DanNixon/microsd-hexpansion/README.md

# uSD Card Hexpansion

Micro SD card hexpansion for the [Tildagon](https://tildagon.badge.emfcamp.org/) badge.

- [Purchase](https://themachineshop.uk/products/dual-sd-card-hexpansion)
- [Documentation](./docs)

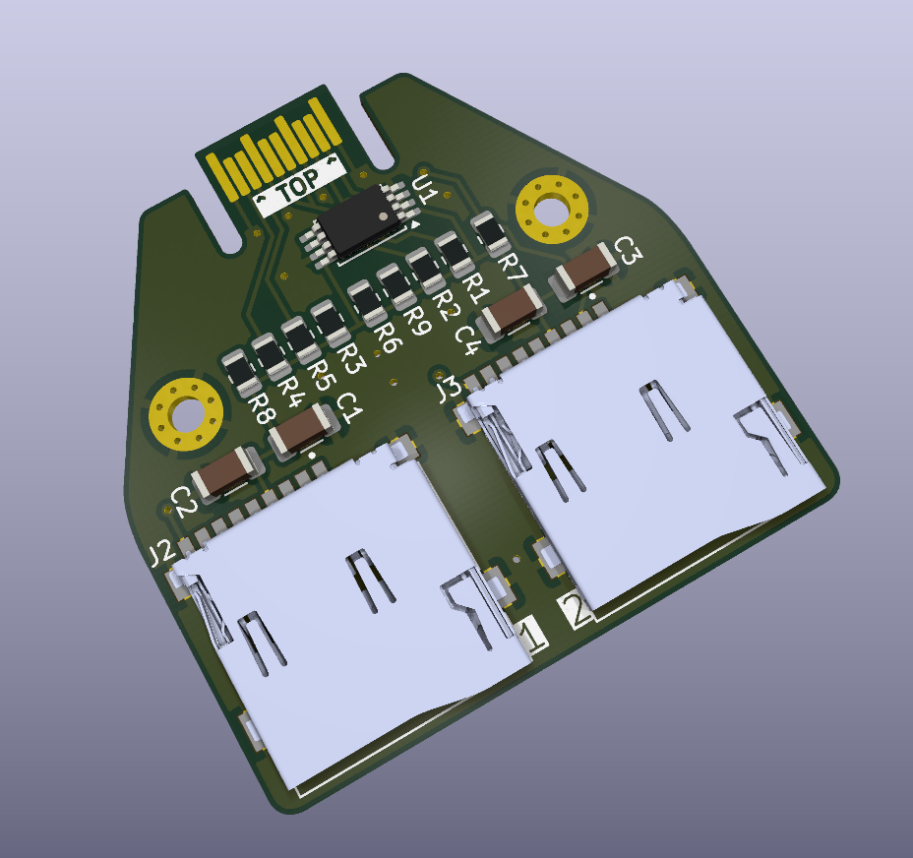
[picture p1: docs/render-front.png]
Render of PCB front
