DanNixon/microsd-hexpansion/docs/pins.md

# Pinout

|Function |Pin |
|---|----|
|MOSI |HS 2|
|MISO |HS 4|
|SCK |HS 3|
|CS slot 1 |HS 1|
|CS slot 2 |LS 5|
|Detect slot 1|LS 1|
|Detect slot 2|LS 4|
