DanNixon/microsd-hexpansion/demo-firmware/src/main.rs

#![no_std]
#![no_main]
#![deny(
    clippy::mem_forget,
    reason = "mem::forget is generally not safe to do with esp_hal types, especially those \
    holding buffers for the duration of a data transfer."
)]

use core::cell::RefCell;
use defmt::info;
use embassy_embedded_hal::shared_bus::blocking::spi::SpiDevice;
use embassy_executor::Spawner;
use embassy_sync::blocking_mutex::NoopMutex;
use embassy_time::{Delay, Timer};
use embedded_sdmmc::SdCard;
use panic_rtt_target as _;
use static_cell::StaticCell;
use tildagon::{
    embedded_aw9523::{
        PinConfiguration,
        async_traits::digital::{InputPin, OutputPin},
    },
    esp_hal::{
        self,
        clock::CpuClock,
        dma::{DmaRxBuf, DmaTxBuf},
        dma_buffers,
        gpio::{Level, Output},
        spi::{
            Mode,
            master::{Config, Spi, SpiDmaBus},
        },
        time::Rate,
        timer::timg::TimerGroup,
    },
    hexpansions::{HexpansionSlot, HexpansionSlotControl},
    i2c::SharedI2cBus,
    pins::PinControl,
    resources::*,
    usb::{UsbPort, UsbSwitch},
};

extern crate alloc;

// This creates a default app-descriptor required by the esp-idf bootloader.
// For more information see: <https://docs.espressif.com/projects/esp-idf/en/stable/esp32/api-reference/system/app_image_format.html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>
esp_bootloader_esp_idf::esp_app_desc!();

#[esp_rtos::main]
async fn main(_spawner: Spawner) {
    rtt_target::rtt_init_defmt!();

    let config = tildagon::esp_hal::Config::default().with_cpu_clock(CpuClock::max());
    let p = tildagon::esp_hal::init(config);
    let r = tildagon::split_resources!(p);

    esp_alloc::heap_allocator!(size: 64 * 1024);
    // COEX needs more RAM - so we've added some more
    esp_alloc::heap_allocator!(#[unsafe(link_section = ".dram2_uninit")] size: 64 * 1024);

    let timg0 = TimerGroup::new(p.TIMG0);
    esp_rtos::start(timg0.timer0);

    static I2C_BUS: StaticCell<SharedI2cBus<tildagon::i2c::I2c>> = StaticCell::new();
    let (bus, _reset) = tildagon::i2c::i2c_bus(r.i2c).await;
    let i2c_bus = I2C_BUS.init(bus);

    static I2C_SYSTEM: StaticCell<SharedI2cBus<tildagon::i2c::SystemI2cBus>> = StaticCell::new();
    let i2c_system = I2C_SYSTEM.init(tildagon::i2c::system_i2c_bus(i2c_bus));

    let mut pin_control = PinControl::new(i2c_system).await.unwrap();
    let pins = pin_control.pins();

    let mut usb_sw = UsbSwitch::new(pins.usb);
    usb_sw.set(UsbPort::In).await.unwrap();

    let mut hex_slots = HexpansionSlotControl::new(pins.hexpansion_detect)
        .await
        .unwrap();

    let hex_a_fast = r.hexpansion_a;
    let hex_a_slow = pins.hexpansion_a;

    hex_slots
        .set_enabled(HexpansionSlot::A, true)
        .await
        .unwrap();

    let mut card_detect_1 = hex_a_slow.ls_1.try_into_input().await.unwrap();
    let mut card_detect_2 = hex_a_slow.ls_4.try_into_input().await.unwrap();

    let cs_1 = Output::new(hex_a_fast.hs_1, Level::High, Default::default());
    let mut cs_2 = hex_a_slow.ls_5.try_into_output().await.unwrap();
    cs_2.set_high().await.unwrap();

    let (rx_buffer, rx_descriptors, tx_buffer, tx_descriptors) = dma_buffers!(32000);
    let dma_rx_buf = DmaRxBuf::new(rx_descriptors, rx_buffer).unwrap();
    let dma_tx_buf = DmaTxBuf::new(tx_descriptors, tx_buffer).unwrap();

    let spi = Spi::new(
        p.SPI3,
        Config::default()
            .with_frequency(Rate::from_mhz(16))
            .with_mode(Mode::_0),
    )
    .unwrap()
    .with_sck(hex_a_fast.hs_3)
    .with_mosi(hex_a_fast.hs_2)
    .with_miso(hex_a_fast.hs_4)
    .with_dma(p.DMA_CH1)
    .with_buffers(dma_rx_buf, dma_tx_buf);

    static SPI: StaticCell<NoopMutex<RefCell<SpiDmaBus<'static, esp_hal::Blocking>>>> =
        StaticCell::new();
    let spi = SPI.init(NoopMutex::new(RefCell::new(spi)));

    let sdcard_1 = SdCard::new(SpiDevice::new(spi, cs_1), Delay);
    let sdcard_2 = SdCard::new(SpiDevice::new(spi, cs_2), Delay);

    loop {
        let card_1_detect = card_detect_1.is_low().await;
        let card_2_detect = card_detect_2.is_low().await;

        info!("Card 1 detect: {}", card_1_detect);
        info!("Card 2 detect: {}", card_2_detect);

        if card_1_detect == Ok(true) {
            info!("Card 1 type {}", sdcard_1.get_card_type());
            info!("Card 1 size is {} bytes", sdcard_1.num_bytes().unwrap());
        }

        if card_2_detect == Ok(true) {
            info!("Card 2 type {}", sdcard_2.get_card_type());
            info!("Card 2 size is {} bytes", sdcard_2.num_bytes().unwrap());
        }

        Timer::after_secs(1).await;
    }
}
