DanNixon/microsd-hexpansion/(commit log)

2026-06-17 Add missing card detect pullups
    [hexpansion.kicad_pcb, hexpansion.kicad_sch]
2026-06-19 Reduce BOM cost for assenbly
    - swap uSD slot with a cheaper alternative
    - swap capacitors for 0805 equivalents
    - add KiKit automation for assembly files
    [bom.csv, hexpansion.kicad_pcb, hexpansion.kicad_sch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]
